mamutedesenrascado-del/raidtrack/README.md

# RaidTrack

Acompanhamento de equipas de escuteiros em raids por rádio LoRa — posição, mensagens e SOS — sem rede móvel, sem SIM, sem subscrições.

```
 Equipas (T-Beam V1.2)            Base (T3-S3)                App da base
 GPS + botões + SOS  ── LoRa 868 ──►  recetor  ── USB ──► PC Windows/Mac (Chrome/Edge)
                      ◄─ mensagens ─            ── BLE ──► Android / iPhone / tablet
```

| Pasta | Conteúdo |
|---|---|
| `firmware/RaidTrack/` | Módulo C++ para o Meshtastic (SOS, confirmação, pedido de posição) |
| `firmware/raidtrack.ini` | Ambientes de compilação `raidtrack-equipa` (T-Beam) e `raidtrack-base` (T3-S3) |
| `app/instalador.html` | **Preparar rádios**: grava e configura pelo browser, sem terminal |
| `firmware/compilar.py` | Alternativa: compila e grava no PC (Windows/Mac) |
| `firmware/configurar.py` | Alternativa: configura cada rádio pela linha de comandos |
| `app/` | App da base: uma só base de código para PC, Android e iOS |
| `docs/PROTOCOLO.md` | Protocolo rádio, botões/GPIO e orçamento de tempo de antena |
| `.github/workflows/publicar.yml` | Compila o firmware e publica app + instalador no GitHub Pages |

Base: Meshtastic **v2.8.2.d5f1619** (estável). O módulo entra pelo mecanismo oficial de módulos opcionais (`src/modules/optional/`) — não altera nenhum ficheiro do Meshtastic, por isso atualizar a versão é só mudar a tag.

---

## 1. Hardware das equipas (T-Beam V1.x ou T-Beam Supreme)

Botões entre o GPIO e GND (o firmware ativa o pull-up interno). O instalador deteta a placa e usa os pinos certos.

| Botão | T-Beam V1.x (ESP32) | T-Beam Supreme (ESP32-S3) |
|---|---|---|
| SOS — 12 mm, vermelho | 14 | 38 |
| Cima | 25 | 39 |
| Baixo | 13 | 21 |
| OK | 15 | 48 |
| Besouro ativo 3,3 V (opcional, + ao GPIO, − ao GND) | 2 | 2 |

SOS: **premir 2 s** dispara (3 bips, ecrã "SOS ENVIADO"); repete a cada 30 s até a base confirmar (bip longo, "BASE RECEBEU O SOS"). **Premir 5 s** com SOS ativo cancela.

**Caixa impressa em 3D (T-Beam Supreme, na vertical, com teclado e SOS):** ver [enclosure/](enclosure/README.md).

### Ecrã do tracker (modo quiosque)
O tracker de equipa já não mostra os painéis do Meshtastic (nós, GPS, LoRa, sistema…) nem os menus: o RaidTrack desenha o ecrã inteiro e recebe todos os botões. Vem **na vertical, com a antena para cima**; no menu, **Rodar ecrã** passa pelas 4 posições (vertical para um lado, para o outro, horizontal, horizontal invertida) e fica guardado no rádio.

| Ecrã | O que mostra |
|---|---|
| Início | código da equipa, bateria, GPS, há quanto tempo ouviu a rede, como fazer SOS |
| Menu | Enviar mensagem · Mensagens lidas · Rodar ecrã · Voltar |
| Enviar | as mensagens rápidas ("Chegámos ao posto"…), com confirmação |
| Aviso da base / zona proibida | por cima de tudo, com páginas, até carregar **OK** (a base vê "lida") |
| SOS | ecrã cheio até a base confirmar |

Botões: **cima** = anterior, **baixo** = seguinte, **OK** = escolher. Só com o botão do próprio T-Beam: **carregar** = seguinte, **manter meio segundo** = OK. Os menus do Meshtastic, desligar pelo botão e reposição de fábrica ficam bloqueados.

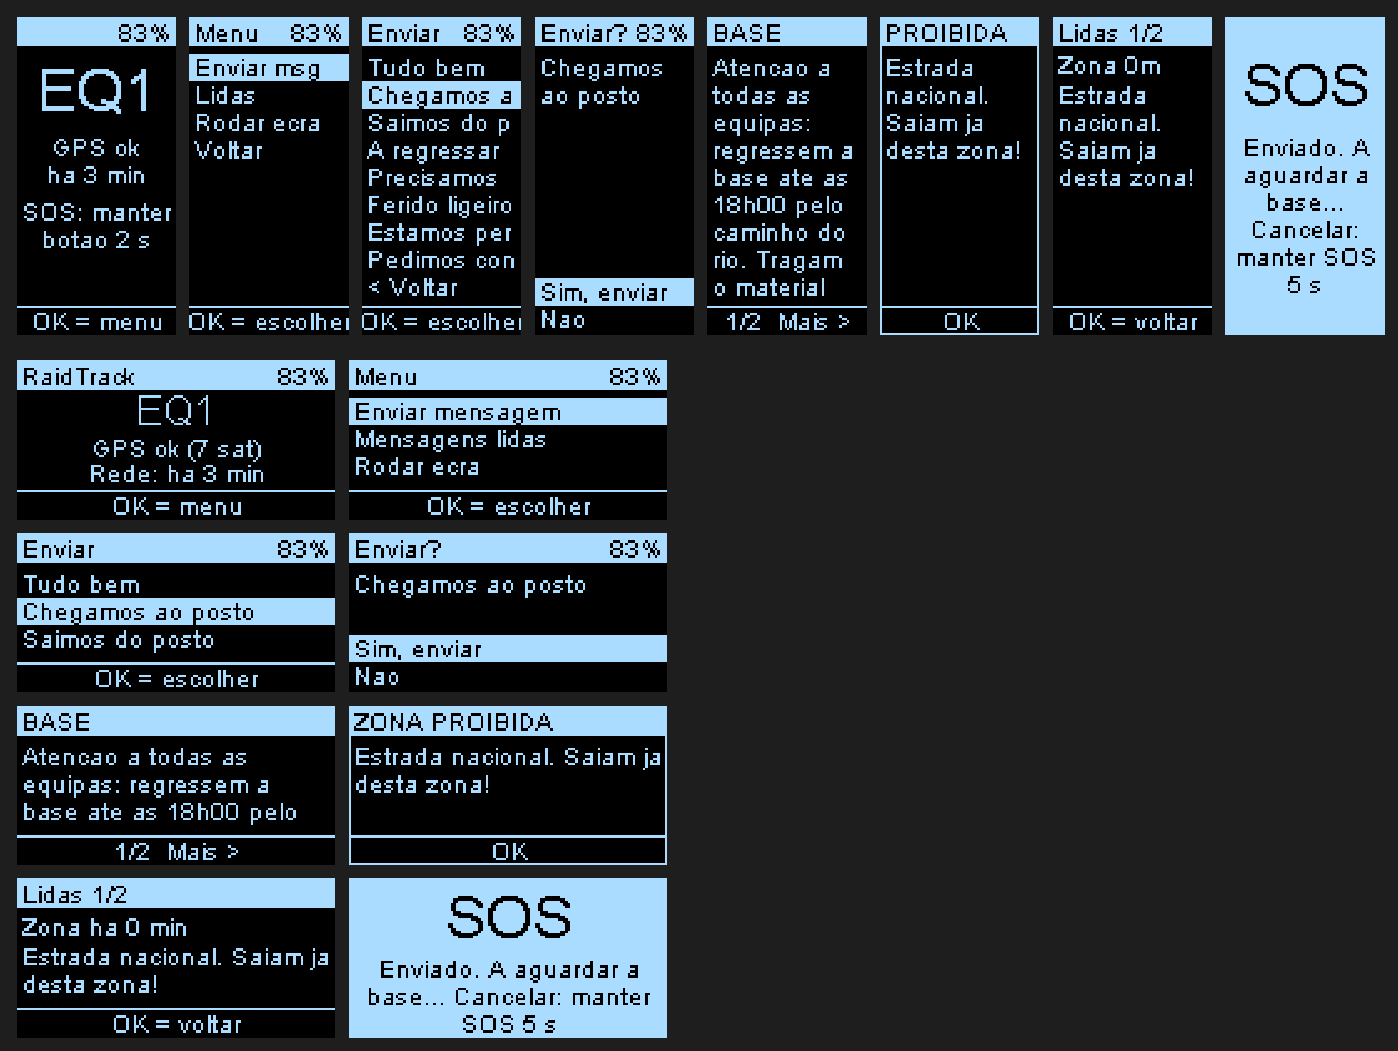
[picture p1: docs/ecras-tracker.png]
Ecrãs do tracker na vertical e na horizontal


## 2. Pôr tudo a funcionar (sem terminal)

**Uma vez só — publicar no GitHub:**
1. Criar uma conta e um repositório no GitHub e enviar esta pasta (Passo 7A do guia).
2. Em **Settings → Pages → Source** escolher **GitHub Actions**.
3. O workflow *Publicar RaidTrack* compila os dois firmwares na cloud e publica, no mesmo endereço:
   - `https://<utilizador>.github.io/<repositório>/` — a app da base;
   - `https://<utilizador>.github.io/<repositório>/instalador.html` — **Preparar rádios**.

Sempre que o código muda no GitHub, o firmware e a app são recompilados e republicados sozinhos.

**Preparar os rádios (Chrome ou Edge, Windows ou Mac):**
1. Abrir **Preparar rádios** (também há um botão na app da base).
2. **Chave do raid:** *Gerar nova* (ou colar a existente). Fica guardada no computador; *Mostrar QR* passa-a a outro computador.
3. Escolher **Equipa** (código EQ1, EQ2… sugerido automaticamente) ou **Base**.
4. Ligar o rádio por USB → **Gravar e configurar** → escolher a porta. O browser grava o firmware e configura: região EU868, canal cifrado, nome, posição, botões e mensagens pré-definidas.
5. "Pronto" → ligar o próximo rádio.

*Só configurar* muda a chave, o nome ou o intervalo de posição sem voltar a gravar o firmware. Sem Internet ou sem o GitHub, o instalador aceita um ficheiro `.factory.bin` compilado à mão.

### Alternativa técnica — terminal
`firmware/compilar.py` (compilar e gravar no PC) e `firmware/configurar.py` (configurar por linha de comandos) continuam disponíveis; ver o guia de implementação.

## 3. App da base

### PC (Windows / Mac) — recomendado
Abrir o endereço publicado (ver secção 2) o endereço em **Chrome ou Edge** → ícone *Instalar app* na barra de endereço. Depois de aberta uma vez com Internet funciona **offline**. Ligar o T3-S3 por USB → **Ligar USB**.

Para testar localmente: `cd app && npm install && npm run dev`.

### Android
Chrome no Android abre a mesma página e liga por **Bluetooth** (Web Bluetooth). Para app instalável na Play Store / APK: `npm run cap:android` (precisa do Android Studio).

### iPhone / iPad
O Safari não suporta Bluetooth Web. Duas vias:
- **Já:** browser gratuito *Bluefy* (App Store), que suporta Web Bluetooth, a abrir o endereço da app (precisa de Internet para abrir a app).
- **App nativa:** `npm run cap:ios` num Mac com Xcode. Acrescentar ao `ios/App/App/Info.plist`:
  `NSBluetoothAlwaysUsageDescription` = "Ligação ao rádio RaidTrack da base".

### Usar sem Internet (portátil)
A app guarda-se toda no computador na primeira vez que é aberta com Internet (incluindo o relatório PDF e o instalador dos rádios). No dia do raid abre sem Internet e liga ao rádio da base por USB ou Bluetooth.
1. Em casa, com Internet: abrir a app no **Chrome ou Edge** e, de preferência, **Instalar app** (ícone na barra de endereço) — fica como um programa no ambiente de trabalho.
2. Abrir ou fazer o plano; em **Plano → Usar sem Internet** carregar **Guardar mapa da zona do plano** (1,5 km à volta do percurso, postos e zonas).
3. A lista "Usar sem Internet" mostra se está tudo pronto (app, mapa, plano, ligação ao rádio).
4. No campo: abrir o RaidTrack (ou o endereço) sem Internet e ligar o rádio.

### Antes do raid
1. **Mapa offline:** com Internet, enquadrar a zona do raid e carregar **Mapa offline** (guarda os mosaicos OpenTopoMap da zona, até 4000 mosaicos), ou usar **Guardar mapa da zona do plano**.
2. **Base aqui:** marca a posição da base → distância e rumo de cada equipa.
3. **Demonstração:** 5 equipas simuladas, SOS da EQ2 aos 25 s — serve para treinar os operadores.

### Durante o raid
- Cartões de equipa: última posição, bateria, sinal, distância/rumo à base. Estado *Sinal atrasado* > 3 min, *Sem sinal* > 10 min.
- **Localizar / Localizar todas:** pede posição imediata.
- **SOS:** alarme sonoro + cartão vermelho → **Recebido — avisar equipa** envia a confirmação ao tracker. Se a equipa continuar a repetir, a app volta a confirmar sozinha.
- Mensagens para uma equipa ou para todas: ficam no ecrã do tracker até a equipa carregar **OK**, e a app mostra quando foi lida.
- **Horas de partida e chegada** em cada cartão (escrever `hh:mm` ou **Agora**): a distância, o tempo e a % no percurso contam só entre essas horas.
- **Exportar:** percursos em GPX (abre no Google Earth/QGIS) e registo do raid em CSV.

### Separador Plano — preparar o raid (também sem rádio ligado)
- **Plano do raid:** nome e data. **Guardar plano** descarrega um ficheiro `.raidtrack` com tudo o que está abaixo e, se marcado, o **mapa da zona** (até 500 mosaicos topográficos). **Abrir plano** carrega-o noutro dia ou noutro computador — no dia do raid funciona **sem Internet**, com o mapa incluído. Abrir um plano mantém as equipas e posições do raid em curso. A chave do rádio não vai no ficheiro.
- **Percurso teórico** (GPX trk, rte ou só pontos; os `wpt` passam a postos). Corredor (50 m) e velocidade média (3,5 km/h): o tempo previsto soma 1 h por cada 500 m de subida se o GPX tiver altitude.
- **Reconhecimento:** um ou mais GPX feitos no terreno, a azul no mapa, com a % que coincide com o percurso.
- **Postos:** do GPX ou **Adicionar posto no mapa**; nome, raio (40 m) e notas. A passagem fica **registada automaticamente** quando a equipa chega a menos do raio (também entre duas posições, porque o GPS só envia de minuto a minuto), com a diferença para a hora prevista.
- **Zonas proibidas** (o tracker apita até OK) e **zonas de perigo** (a base é avisada quando a equipa está a menos de X m; opcionalmente também o tracker, com uma mensagem que fica no ecrã até OK).
- **Equipas previstas:** código (igual ao do tracker), nome, elementos e partida prevista (usada nas horas previstas enquanto não houver partida real).
- **Segurança e notas:** ponto de encontro, hospital, contactos de emergência, notas.
- **Mensagens programadas:** hora, destino e texto; enviadas sozinhas com o rádio ligado (até 30 min de atraso).
- **Alertas** (0 desliga): equipa **parada** há X min fora dos postos e da base, **sem contacto** há X min, **fora do percurso** há X min, **bateria** abaixo de X %. Só para equipas que já partiram (hora real ou prevista) e ainda não chegaram.

### Durante e depois do raid
- **Relatório PDF:** resumo (partida, chegada, duração, distância, % no percurso, cobertura, postos, zonas, SOS), mapa geral, e uma página por equipa com mapa, **tabela de postos (previsto / passagem / diferença)**, elementos e eventos. Mapa de fundo OpenStreetMap; sem Internet usa o mapa guardado do plano ou sai com quadrícula.
- **GPX de todas as equipas:** percurso teórico, postos, reconhecimentos e o rasto de cada equipa.
- **Rever o raid:** barra de tempo para ver onde estava cada equipa a cada momento (×30, ×120, ×600).
- **Cobertura rádio:** cada posição recebida fica marcada no mapa com a qualidade do sinal (verde bom → vermelho no limite; cinzento = chegou por repetidor). Serve para decidir onde pôr um repetidor.
