mamutedesenrascado-del/raidtrack/enclosure/teclas.stl

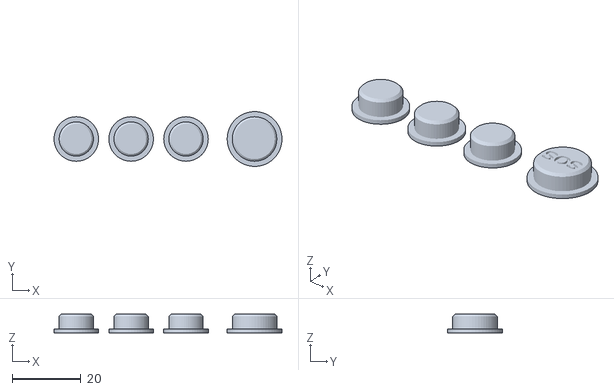
[picture p3: CAD file, 2026-11-11]
enclosure/teclas.stl
66.5 x 16.0 x 5.40
