mamutedesenrascado-del/raidtrack/enclosure/caixa.stl

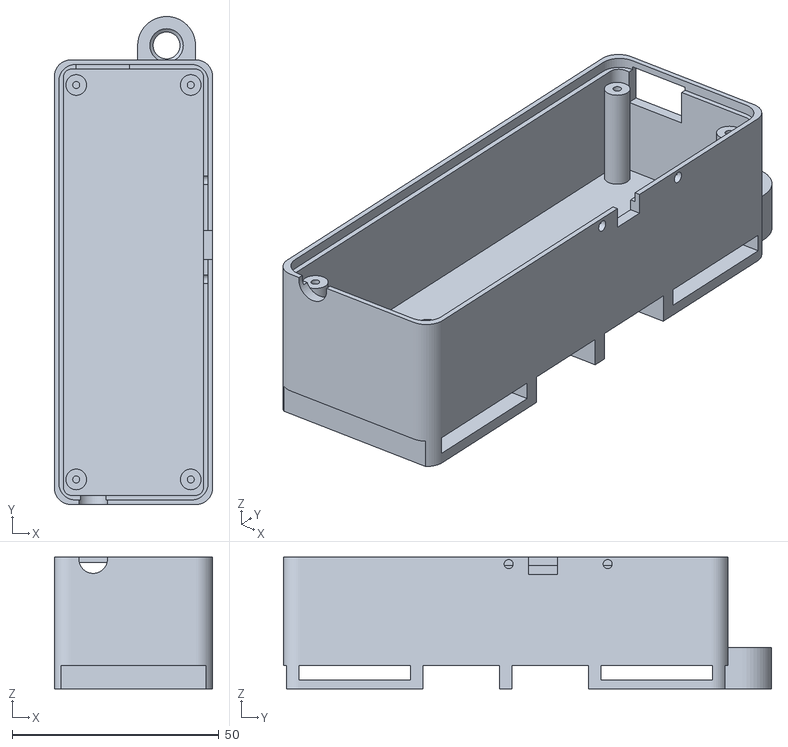
[picture p4: CAD file, 2026-11-11]
enclosure/caixa.stl
38.3 x 118.0 x 31.9
