mamutedesenrascado-del/raidtrack/enclosure/tampa.stl

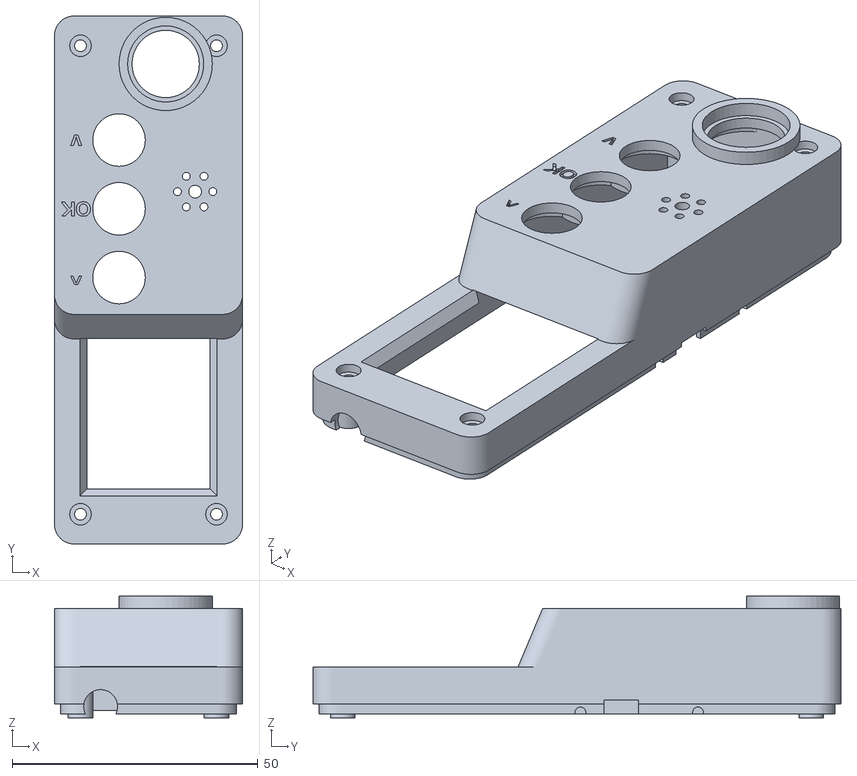
[picture p5: CAD file, 2026-11-11]
enclosure/tampa.stl
38.3 x 107.5 x 24.8
