mamutedesenrascado-del/raidtrack/enclosure/suporte.stl

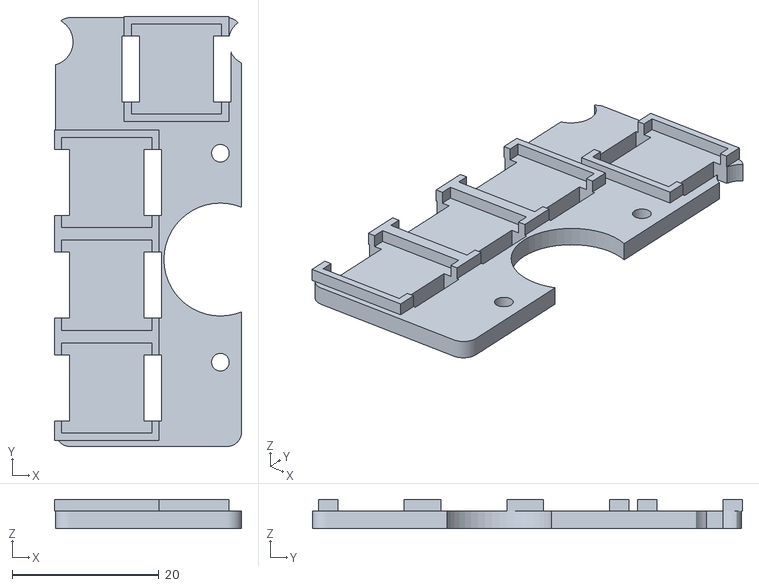
[picture p6: CAD file, 2026-11-11]
enclosure/suporte.stl
25.6 x 58.6 x 3.99
