mamutedesenrascado-del/raidtrack/(commit log)

2026-11-06 Compilação: fixar pioarduino 6.2.0 (6.2.0.post1 é rejeitado pela plataforma ESP32)
    Claude-Session: https://claude.ai/code/session_01MichuJNW54kx1kpdEuHoN9
2026-11-07 Instalador: instruções de modo de gravação manual quando o rádio não liga
    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
2026-11-07 Instalador: configurar em duas fases (região primeiro, religar após reinício)
    No 1.º arranque o rádio não tem região; ao defini-la cria uma identidade nova
    (o número do nó muda) e os pedidos seguintes ficavam sem resposta. Agora a região
    vai sozinha, o instalador espera o reinício, volta a encontrar a porta USB (que
    no T3-S3 muda) e envia o resto numa transação. Inclui rádio simulado para testes.
    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
2026-11-07 Instalador: recusa gravar firmware feito para outro chip
    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
2026-11-07 Suporte para T-Beam Supreme (ESP32-S3) e deteção automática da placa
    O instalador identifica a placa pelo chip e pela memória flash (T-Beam ESP32,
    T-Beam Supreme 8 MB, T3-S3 4 MB), descarrega o firmware certo e recusa gravar
    se não bater certo com Base/Equipa. Botões do Supreme: 38/39/21/48, besouro 2.
    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
2026-11-07 Instalador: lista de rádios preparados por chave do raid
    Ao gerar ou colar outra chave, a lista passa a mostrar só os rádios dessa chave,
    avisa quantos ficaram com outra chave e a sugestão de código recomeça em EQ1.
    Reconfigurar um rádio já não o duplica na lista.
    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
2026-11-07 Canal RaidTrack com partilha de posição (position_precision 32)
    No Meshtastic 2.8 um canal sem module_settings tem precisão 0 e o rádio
    nunca envia a posição nesse canal — o tracker comunicava mas sem GPS no mapa.
    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
2026-11-07 Bateria das equipas: ativar device_telemetry_enabled
    No Meshtastic 2.8 a telemetria do dispositivo (bateria) já não é enviada para a
    rede por omissão. A biblioteca JS ainda não tem o campo 14, que vai como campo
    desconhecido na configuração.
    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
2026-11-07 Percurso GPX, zonas proibidas, horas, relatório PDF e mensagens até OK
    - Separador Raid: importar percurso teórico (GPX), corredor, desenhar zonas proibidas
    - % no percurso e cobertura por equipa; horas de partida/chegada
    - Zona proibida: alarme na base e aviso ZONE (0x05) ao tracker, que apita até OK
    - Mensagens da base como TEXT (0x06): ficam no ecrã do tracker até OK; READ (0x07) volta à base
    - Relatório PDF com mapa geral e uma página por equipa; GPX com percurso teórico e todas as equipas
    - Demonstração com percurso, zona e confirmações de leitura
    Claude-Session: https://claude.ai/code/session_01MichuJNW54kx1kpdEuHoN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
2026-11-07 Pré-visualização do relatório na demonstração; demo sem pedidos de mosaicos
    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
2026-11-09 Relatório: carateres corrigidos, mapa de fundo, posições antigas e datas
    - Seta e emojis no PDF saíam como lixo (só Windows-1252 nas letras base)
    - Mapa de fundo: o service worker devolvia mosaicos opacos ao pedido CORS do relatório
    - Última posição antiga devolvida pelo rádio ao ligar já não entra no rasto
    - Sem hora de partida conta desde o início do raid; datas quando o raid passa a meia-noite
    - Contagem de SOS já não conta o 'SOS resolvido'
    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
2026-11-11 Planner de raid, postos com registo automático, alertas, mensagens programadas, rever o raid e cobertura rádio
    - Separador Plano: percurso (com altitude), reconhecimentos, postos, zonas proibidas/perigo, equipas previstas,
    segurança e notas, mensagens programadas, alertas; ficheiro .raidtrack com mapa offline incluído
    - Postos: tempo previsto por troço (velocidade + subida), passagem registada automaticamente, adiantada/atrasada
    - Alertas: parada, sem contacto, fora do percurso, bateria; zonas de perigo com aviso opcional ao tracker
    - Rever o raid com barra de tempo; mapa de cobertura com SNR por posição
    - Relatório: postos, zonas de perigo, segurança; OpenTopoMap como fonte (func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
2026-11-11 Tracker de equipa em modo quiosque: ecrã próprio na vertical (ou horizontal) e sem menus do Meshtastic
    - RaidTrackKiosk.cpp: início, menu, enviar mensagem rápida com confirmação, mensagens lidas, avisos com páginas, SOS
    - Desenho num canvas 64x128 ou 128x64 rodado para o OLED; 4 orientações guardadas em /prefs/raidtrack.dat
    - Todos os botões vão para o RaidTrack (incl. botão do T-Beam: carregar = seguinte, manter = OK)
    - firmware/patches/kiosk.patch: ganchos em Screen.cpp e InputBroker.cpp, aplicado no CI e no compilar.py
    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
2026-11-11 Caixa vertical para o T-Beam Supreme (impressão 3D) com teclado, SOS e besouro
    - enclosure/raidtrack-supreme.scad: modelo paramétrico a partir do modelo 3D oficial da LilyGO
    - caixa.stl, tampa.stl, teclas.stl; guia de montagem, lista de compras e ligações
    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
    [caixa.stl, raidtrack-supreme.scad, tampa.stl, teclas.stl]
2026-11-11 Caixa: teclas redondas com anel-guia e suporte dos botões, grelha do besouro, passadores de fita 25 mm e argola de segurança
    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
    [caixa.stl, raidtrack-supreme.scad, suporte.stl, tampa.stl, teclas.stl]
2026-11-11 Quiosque: vertical com a antena para cima por omissão (sentido confirmado no rádio)
    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
2026-11-13 App da base funciona sem Internet: todos os ficheiros guardados na 1.ª visita e painel 'Usar sem Internet'
    - sw.js: lista completa de ficheiros (gerada na compilação) e versão; corrigido clone tardio que impedia a cache
    - cache primeiro para assets/firmware, rede com limite de 4 s para páginas
    - Plano → Usar sem Internet: estado da app, mapa, plano, armazenamento e ligação; guardar mapa da zona do plano
    - pede armazenamento persistente ao browser
    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
